mozkan/weddingdress/README.md

# WedfestDress

Datasheets are not checked into this repository. They can be found here:
https://www.dropbox.com/sh/xb0569z05b4rpry/AAB6PzJzVCwgI6VpaBfMWfP8a?dl=0
