mozkan/weddingdress/hw/pcb/controller/bom/Wedfestdress Controller BOM.ods

Qty | Parts | DESCRIPTION | MFG | MFG_PART_NO | DISTRIBUTOR | DIST_PART_NO | COST_X1 | COST_X100 | COST_X500 | PACKAGE | NOSTUFF | Required Qty.
1 | J1 | USB Micro B | FCI | 10118192-0001LF | Digikey | 609-4613-1-ND | 0.46 | 0.3032 | 0.25988 | SMT |  | 5
1 | U23 | Accelerometer, 3G, 550 Hz / 1.6 kHz | Analog Devices | ADXL337BCPZ-RL7 | Digikey | ADXL337BCPZ-RL7CT-ND | 4.58 | 3.3677 | 2.86682 | SMT |  | 5
5 | C2, C3, C12, C13, C15 | Capacitor, 0.1 uF, 50V, 0603, X7R | TDK | C1608X7R1H104K080AA | Digikey | 445-1314-1-ND | 0.1 | 0.022 | 0.0154 | 603 |  | 25
2 | C7, C8 | Capacitor, 4.7 uF, 10V, 0603, X5R | TDK | CGB3B1X5R1A475M055AC | Digikey | 445-7483-1-ND | 0.24 | 0.1 | 0.06626 | 603 |  | 10
2 | C4, C5 | Capacitor, 10 nF, 50V, 0603, X7R | Samsung | CL10B103KB8NNNC | Digikey | 1276-1009-1-ND | 0.1 | 0.0078 | 0.00542 | 603 |  | 10
8 | C6, C9, C10, C11, C16, C17, C18, C19 | Capacitor, 1 uF, 16V, 0603, X5R | Murata | GRM185R61C105KE44D | Digikey | 490-3894-1-ND | 0.11 | 0.0356 | 0.02512 | 603 |  | 40
2 | C1, C14 | Capacitor, 0.1 uF, 25V, 0603, X7R | Murata | GRM188R71E104KA01D | Digikey | 490-1524-1-ND | 0.1 | 0.0088 | 0.00616 | 603 |  | 10
1 | J12 | Connector, 3 pin, 1.25 mm pitch, SMT, R/A | Hirose | DF13-3P-1.25H(20) | Digikey | H2220-ND | 0.46 | 0.3284 | 0.2856 | SMT |  | 5
1 | J3 | Connector, 5 pin, 1.25 mm pitch, SMT, R/A | Hirose | DF13-5P-1.25H(51) | Digikey | H121936CT-ND | 1.24 | 0.9438 | 0.7722 | SMT |  | 5
1 | FB1 | Ferrite Bead, 1k @ 100 MHz, 300 mOhm DCR, 300 mA, 0603 package | Taiyo Yuden | BK1608TS102-T | Digikey | 587-1895-1-ND | 0.1 | 0.0426 | 0.0227 | 603 |  | 5
1 | D3 | LED, Red, 104 mcd @ 20 mA, 0603 | OSRAM | LS Q976-NR-1 | Digikey | 475-2512-1-ND | 0.1 | 0.035 | 0.035 | 603 |  | 5
2 | D1, D2 | LED, Green, Clear, 6 mcd @ 10 mA, 0603 | Lite-On | LTST-C190GKT | Digikey | 160-1183-1-ND | 0.29 | 0.1242 | 0.07038 | 603 |  | 10
1 | U1 | Microcontroller, Cortex M4F + Cortex M0+, 100 MHz, 256 kB flash, 192 kB SRAM | NXP | LPC54114J256BD64QL | Digikey | 568-13034-ND | 7.79 | 5.8259 | 5.07316 | LQFP64 |  | 5
1 | U22 | Digital potentiometer, 100k, 100 taps, I2C | Microchip | MCP4017T-104E/LT | Digikey | MCP4017T-104E/LTCT-ND | 0.53 | 0.4017 | 0.4017 | SC-70-6 |  | 5
1 | U21 | OpAmp, 500 kHz GBWP, rail-to-rail, 50 uA Iq | Microchip | MCP6241UT-E/LT | Digikey | MCP6241UT-E/LTCT-ND | 0.31 | 0.2369 | 0.2369 | SC-70-5 |  | 5
1 | J2 | Connector, 2 position, 3 mm pitch, SMT, RA, 8.5 A per pin | Molex | 436500209 | Digikey | WM1880CT-ND | 2.03 | 1.5782 | 1.5782 | SMT |  | 5
1 | J10 | Connector, 2 position, 1.25 mm pitch, SMT, RA, 1.5 A per pin | Molex | 5041950270 | Digikey | WM10583CT-ND | 0.91 | 0.6938 | 0.56766 | SMT |  | 5
1 | J11 | Connector, 3 position, 1.25 mm pitch, SMT, RA, 1.5 A per pin | Molex | 5041950370 | Digikey | WM10584CT-ND | 1.28 | 0.968 | 0.792 | SMT |  | 5
6 | J4, J5, J6, J7, J8, J9 | Connector, 4 position, 1.25 mm pitch, SMT, RA, 1.5 A per pin | Molex | 5041950370 | Digikey | WM10584CT-ND | 1.28 | 0.968 | 0.792 | SMT |  | 30
30 | TVS1, TVS2, TVS3, TVS4, TVS5, TVS6, TVS7, TVS8, TVS9, TVS10, TVS11, TVS12, TVS13, TVS14, TVS15, TVS16, TVS17, TVS18, TVS19, TVS20, TVS21, TVS22, TVS23, TVS24, TVS25, TVS26, TVS27, TVS28, TVS29, TVS30 | TVS diode, 5 Vs, 5.8 Vbr, 8 Vcl, 0.95 pF, 8 kV, 200 mW | NXP | PESD5V0X1UB,135 | Digikey | 1727-5906-1-ND | 0.45 | 0.288 | 0.22626 | SOD523 |  | 150
2 | R24, R25 | Resistor, 100k, 1%, 0603, 100 ppm/C | Yageo | RC0603FR-07100KL | Digikey | 311-100KHRCT-ND | 0.1 | 0.0052 | 0.00316 | 603 |  | 10
1 | R21 | Resistor, 100k, 1%, 0603, 100 ppm/C | Yageo | RC0603FR-07100KL | Digikey | 311-100KHRCT-ND | 0.1 | 0.0052 | 0.00316 | 603 | NOSTUFF | 5
16 | R1, R6, R7, R8, R9, R10, R11, R12, R13, R14, R15, R16, R17, R18, R19, R26 | Resistor, 10k, 1%, 0603, 100 ppm/C | Yageo | RC0603FR-0710KL | Digikey | 311-10.0KHRCT-ND | 0.01 | 0.0063 | 0.00382 | 603 |  | 80
1 | R2 | Resistor, 15k, 1%, 0603 | Yageo | RC0603FR-0715KL | Digikey | 311-15.0KHRCT-ND | 0.1 | 0.0057 | 0.00348 | 603 |  | 5
1 | R5 | Resistor, 1.5k, 1%, 0603 | Yageo | RC0603FR-071K5L | Digikey | 311-1.50KHRCT-ND | 0.1 | 0.0057 | 0.00348 | 603 | NOSTUFF | 5
4 | R20, R29, R30, R31 | Resistor, 1K, 1%, 0603 | Panasonic | ERJ-3EKF1001V | Digikey | P1.00KHCT-ND | 0.1 | 0.0114 | 0.00624 | 603 |  | 20
2 | R22, R23 | Resistor, 2.2k, 1%, 0603, 100 ppm/C | Panasonic | ERJ-3EKF2201V | Digikey | P2.20KHCT-ND | 0.1 | 0.0084 | 0.00514 | 603 |  | 10
2 | R3, R4 | Resistor, 33R, 0603 | Yageo | RC0603FR-0733RL | Digikey | 311-33.0HRCT-ND | 0.1 | 0.0057 | 0.00348 | 603 |  | 10
12 | U4, U5, U6, U7, U8, U9, U10, U11, U12, U13, U14, U15 | Level shifter, 1 channel, 5.5 V | Texas Instruments | SN74LVC1T45DCKR | Digikey | 296-16844-1-ND | 0.58 | 0.3699 | 0.29056 | SC-70-6 |  | 60
1 | U2 | LDO, 3.3V, 200 mA, 1%, 0.22V dropout | Toshiba | TCR2LF33,LM(CT | Digikey | TCR2LF33LM(CTCT-ND | 0.45 | 0.1911 | 0.10816 | SMV |  | 5
6 | U3, U16, U17, U18, U19, U20 | Load switch, high side, 3A | TI | TPS27081ADDCR | Digikey | 296-34970-1-ND | 0.44 | 0.2781 | 0.2043 | SOT-23-6 |  | 30
12 | TP1, TP2, TP3, TP4, TP5, TP6, TP7, TP8, TP9, TP10, TP11, TP12 | Test point, SMT, circular, 1.6 mm diameter |  |  |  |  |  |  |  |  |  | 60
1 | SW4 | Switch, SPDT, Sub-Miniature, RA, SMT | Copal | CL-SB-22B-12T | Digikey | 563-1345-1-ND | 1.35 | 1.0771 | 1.0502 | SMT |  | 5
3 | SW1, SW2, SW3 | Tact Switch, SPST, Vert | C and K | KMR221NG LFS | Digikey | CKN10244CT-ND | 0.51 | 0.4017 | 0.34694 | SMT |  | 15
Build Qty
5
