mozkan/weddingdress/hw/pcb/microphone/bom/Wedfestdress Microphone BOM.ods

Qty | Parts | DESCRIPTION | MFG | MFG_PART_NO | DISTRIBUTOR | DIST_PART_NO | COST_X1 | COST_X100 | COST_X500 | PACKAGE | NOSTUFF | Required Qty.
1 | C3 | Capacitor, 0.1 uF, 50V, 0603, X7R | TDK | C1608X7R1H104K080AA | Digikey | 445-1314-1-ND | 0.1 | 0.022 | 0.0154 | 603 |  | 5
2 | C1, C2 | Capacitor, 4.7 uF, 10V, 0603, X5R | TDK | CGB3B1X5R1A475M055AC | Digikey | 445-7483-1-ND | 0.24 | 0.1 | 0.06626 | 603 |  | 10
1 | C4 | Capacitor, 2.2 uF, 10V, 0603, X5R | Samsung | CL10A225KP8NNNC | Digikey | 1276-1085-1-ND | 0.12 | 0.0408 | 0.02878 | 603 |  | 5
1 | C5 | Capacitor, 15 pF, 50V, 0603, C0G/NP0 | Samsung | CL10C150JB8NNNC | Digikey | 1276-1296-1-ND | 0.1 | 0.0126 | 0.00898 | 603 |  | 5
1 | U1 | OpAmp, 500 kHz GBWP, rail-to-rail, 50 uA Iq | Microchip | MCP6241UT-E/LT | Digikey | MCP6241UT-E/LTCT-ND | 0.31 | 0.2369 | 0.2369 | SC-70-5 |  | 5
1 | MIC1 | Microphone, electret condenser, omnidirectional, -38 dB sensitivity, 20 Hz - 15 kHz, TH | PUI Audio | POM-5238P-R | Digikey | 668-1324-ND | 2.52 | 1.332 | 1.332 | TH |  | 5
1 | R4 | Resistor, 0R, 0603 | Yageo | RC0603JR-070RL | Digikey | 311-0.0GRCT-ND | 0.1 | 0.0045 | 0.00278 | 603 |  | 5
1 | R7 | Resistor, 100k, 1%, 0603, 100 ppm/C | Yageo | RC0603FR-07100KL | Digikey | 311-100KHRCT-ND | 0.1 | 0.0052 | 0.00316 | 603 |  | 5
2 | R2, R3 | Resistor, 10k, 1%, 0603, 100 ppm/C | Yageo | RC0603FR-0710KL | Digikey | 311-10.0KHRCT-ND | 0.01 | 0.0063 | 0.00382 | 603 |  | 10
1 | R1 | Resistor, 2.2k, 1%, 0603, 100 ppm/C | Panasonic | ERJ-3EKF2201V | Digikey | P2.20KHCT-ND | 0.1 | 0.0084 | 0.00514 | 603 |  | 5
1 | R6 | Resistor, 49R9, 1%, 0603, 100 ppm/C | Yageo | RC0603FR-0749R9L | Digikey | 311-49.9HRCT-ND | 0.1 | 0.0063 | 0.00382 | 603 |  | 5
1 | R5 | Resistor, 75k, 1%, 0603, 100 ppm/C | Yageo | RC0603FR-0775KL | Digikey | 311-75.0KHRCT-ND | 0.1 | 0.006 | 0.006 | 603 |  | 5
3 | TP1, TP2, TP3 | Test point, SMT, circular, 1.6 mm diameter
Build Qty
5
