mozkan/weddingdress/hw/pcb/pixel/bom/Wedfestdress Pixel BOM.ods

Qty | Parts | DESCRIPTION | MFG | MFG_PART_NO | DISTRIBUTOR | DIST_PART_NO | COST_X1 | COST_X100 | COST_X500 | PACKAGE | NOSTUFF | Required Qty. | Notes
1 | U1 | RGB LED, daisy-chainable, SPI-compatible, 5050 case size | iPixel | APA102C | Amazon | B01MG4TG58 | 0.23 | 0.23 | 0.23 | 5050 |  | 175
4 | TVS1, TVS2, TVS3, TVS4 | TVS diode, 5 Vs, 5.8 Vbr, 8 Vcl, 0.95 pF, 8 kV, 200 mW | NXP | PESD5V0X1UB,135 | Digikey | 1727-5906-1-ND | 0.45 | 0.288 | 0.22626 | SOD523 |  | 700 | Alternate (lower cost): MCC ESD5V0D5-TP
8 | TP1, TP2, TP3, TP4, TP5, TP6, TP7, TP8 | Test point, SMT, circular, 1.6 mm diameter
Build Qty
175
