mozkan/weddingdress/doc/LED Wiring Calculations.ods

LED | APA102C
LED max current consumption | 0.04 | A
LED avg. current consumption factor | 0.4
LED avg. current consumption | 0.016 | A
Wire gauge ampacity | 26 | Ohms / 1000 ft | (24 AWG)
Wire gauge ampacity | 0.026 | Ohms / ft
Strip segment | 4 | ft | (one length from waist to floor)
Segments per strip | 3
Strip length | 12 | ft
Strip resistance | 0.312
LED supply voltage | 3.7 | V
LED spacing | 3 | LEDs / ft
LEDs per strip | 36
Max strip current | 1.44 | A
Max strip voltage drop | 0.44928 | V
Min LED supply voltage at strip end | 3.25072 | V
Battery pack energy | 1.4 | Ah
Battery packs | 4
Total dress energy | 5.6 | Ah
Number of strips | 4
Total LEDs | 144
Average dress current | 2.304 | A
Max dress current | 5.76 | A
Dress runtime | 2.43055555555555 | Hours
