mozkan/weddingdress/hw/pcb/controller/controller.brd

## EAGLE design hw/pcb/controller/controller.brd (2017-06-20)

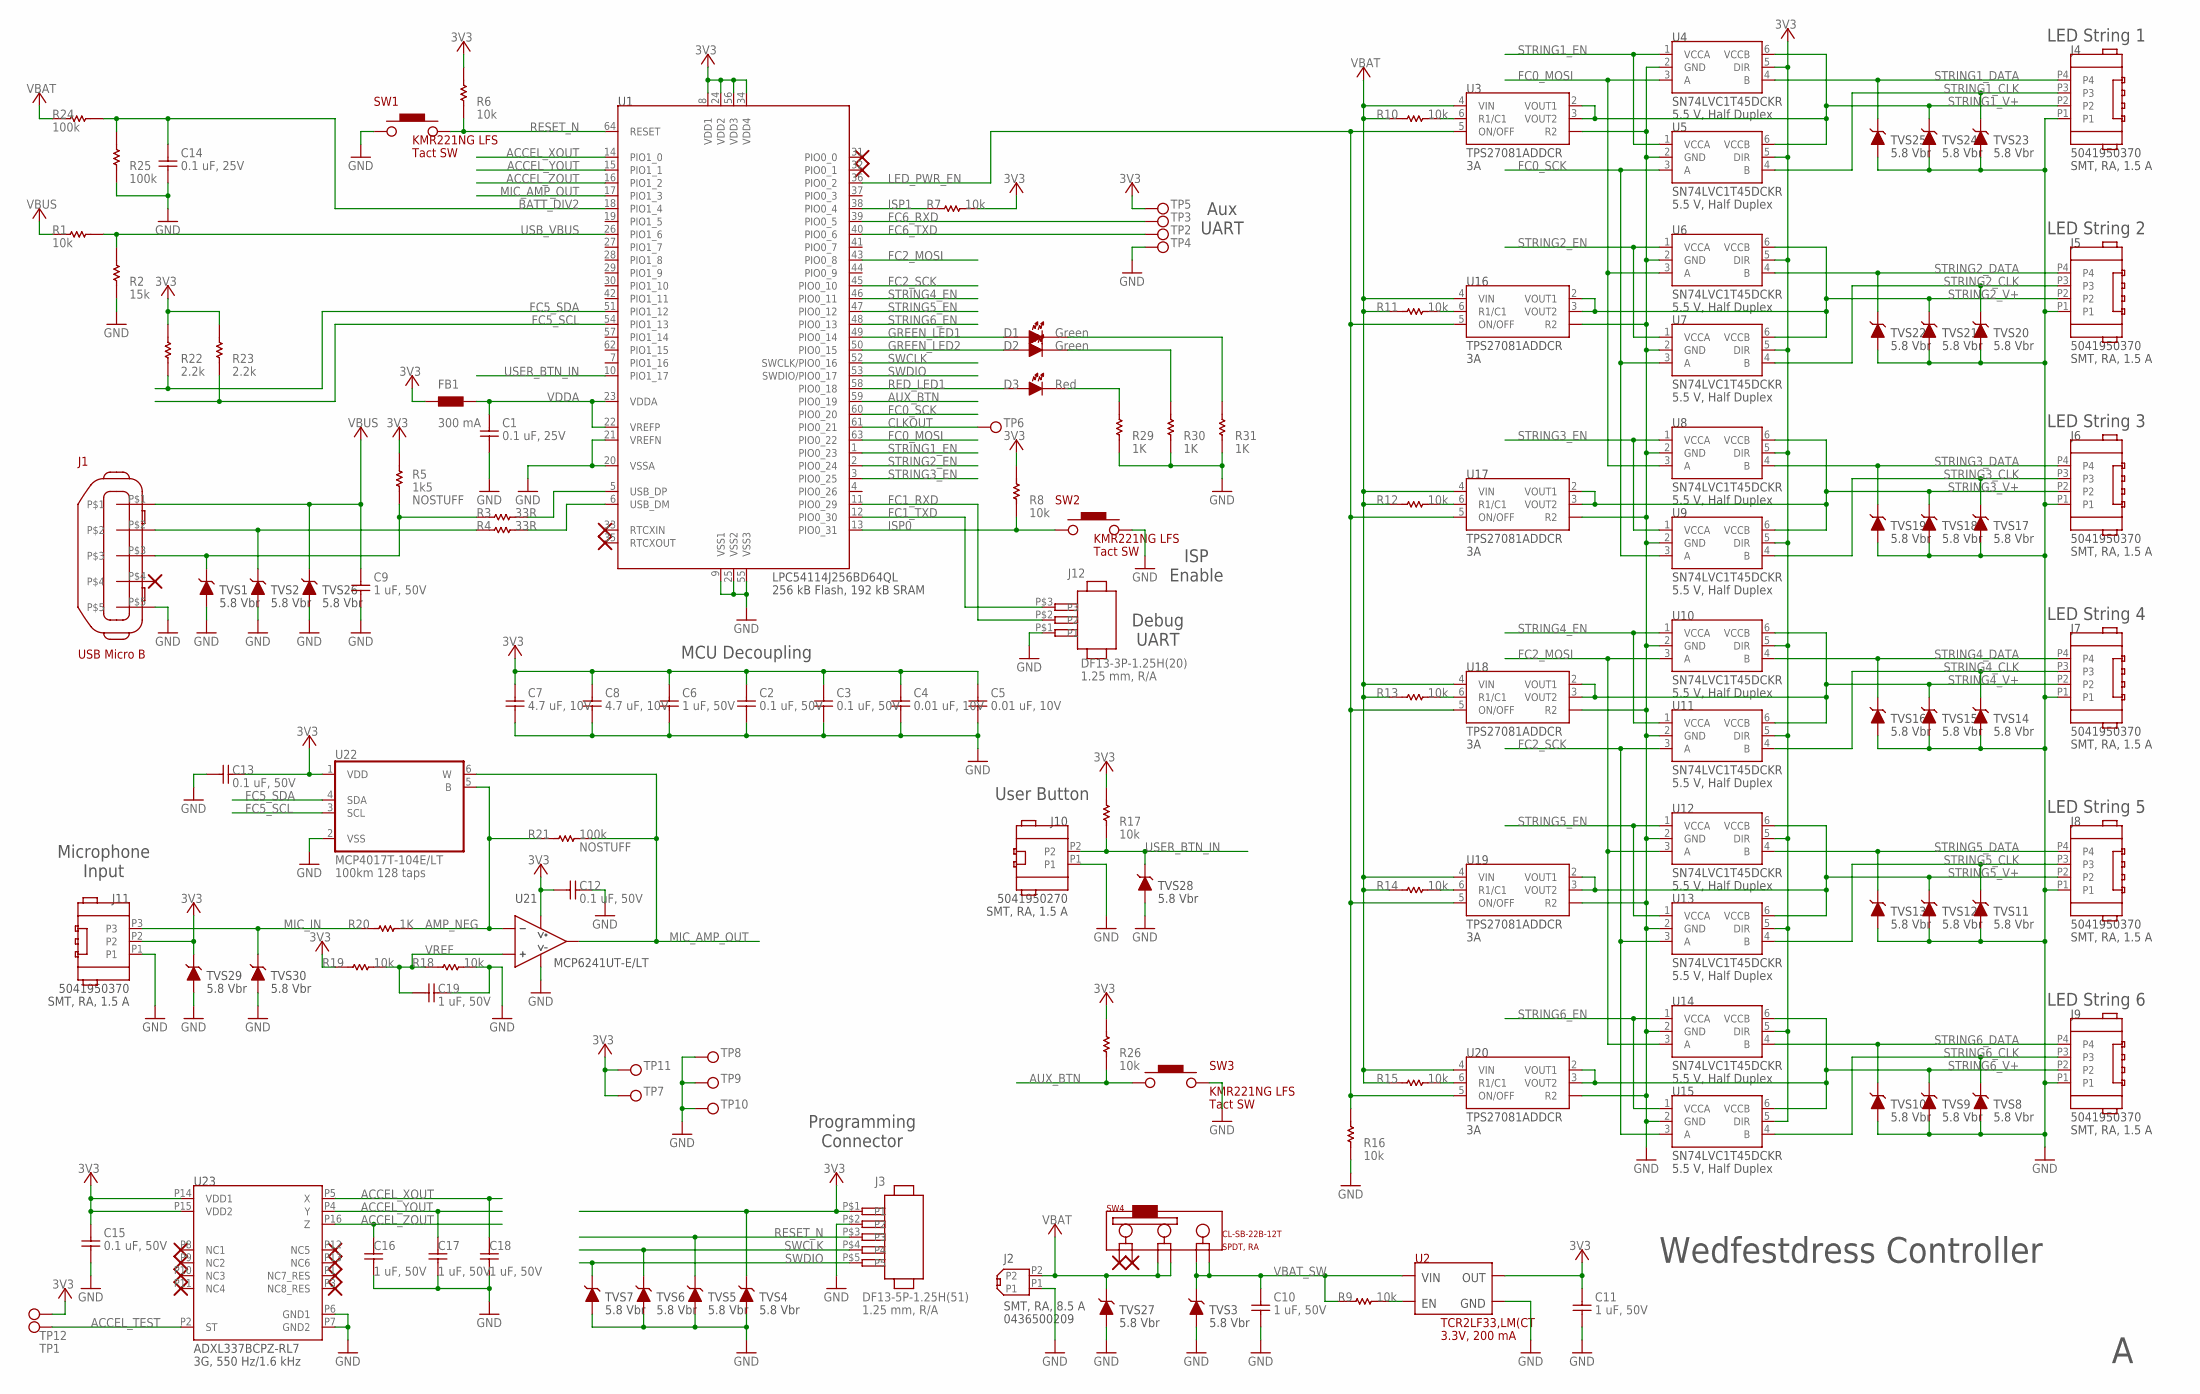
[picture p1: schematic controller.sch]

Parts:
C1, C14: CAP_GRM188R71E104KA01D; CAP_0603
C2, C3, C12, C13, C15: CAP_C1608X7R1H104K080AA; CAP_0603
C4, C5: CAP_CL10B103KB8NNNC; CAP_0603
C6, C9, C10, C11, C16, C17, C18, C19: CAP_GRM185R61C105KE44D; CAP_0603
C7, C8: CAP_CGB3B1X5R1A475M055AC; CAP_0603
D1, D2: LED_LTST-C190GKT; LED_0603
D3: LED_LS_Q976-NR-1; LED_0603_OSRAM
FB1: FB_BK1608TS102-T; FB_0603
J1: 10118192-0001LF
J2: MOLEX_0436500209; MOLEX_MICROFIT_2POS_SMT_RA_W_BOSSES
J3: DF13-5P-1.25H
J4, J5, J6, J7, J8, J9: MOLEX_5041950470; MOLEX_MICROLOCK_RA_4_POS
J10: MOLEX_5041950270; MOLEX_MICROLOCK_RA_2_POS
J11: MOLEX_5041950370; MOLEX_MICROLOCK_RA_3_POS
J12: DF13-3P-1.25H
R1, R6, R7, R8, R9, R10, R11, R12, R13, R14, R15, R16, R17, R18, R19, R26: RES_10K_RC0603FR-0710KL; RES_0603
R2: RES_15K_RC0603FR-0715KL; RES_0603
R3, R4: RES_33R_RC0603FR-0733RL; RES_0603
R5: RES_1K5_RC0603FR-071K5L; RES_0603
R20, R29, R30, R31: RES_1K_ERJ-3EKF1001V; RES_0603
R21, R24, R25: RES_100K_RC0603FR-07100KL; RES_0603
R22, R23: RES_2K2_ERJ-3EKF2201V; RES_0603
SW1, SW2, SW3: KMR221NG; KMR2
SW4: CL-SB-22B-12T
TP1, TP2, TP3, TP4, TP5, TP6, TP7, TP8, TP9, TP10, TP11, TP12: TP_1P6_MM_ROUND
TVS1, TVS2, TVS3, TVS4, TVS5, TVS6, TVS7, TVS8, TVS9, TVS10, TVS11, TVS12, TVS13, TVS14, TVS15, TVS16, TVS17, TVS18, TVS19, TVS20, TVS21, TVS22, TVS23, TVS24, TVS25, TVS26, TVS27, TVS28, TVS29, TVS30: PESD5V0X1UB,135; SOD523
U1: LPC54114J256BD64; LQFP64_0P5MM_10X10MM
U2: TCR2LF33,LM(CT; TOSHIBA_SMV
U3, U16, U17, U18, U19, U20: TPS27081; SOT-23-6_GENERIC
U4, U5, U6, U7, U8, U9, U10, U11, U12, U13, U14, U15: SN74LVC1T45DCKR; SC-70-6_GENERIC
U21: MCP6241UT-E/LT; SC-70-5_GENERIC
U22: MCP4017T; SOT65P210X110-6N
U23: ADXL337

Connections:
3V3: C2.P$1, C3.P$1, C4.P$1, C5.P$1, C6.P$1, C7.P$1, C8.P$1, C11.P$1, C12.P$1, C13.P$2, C15.P$1, FB1.P$1, J3.P$1 (P1), J11.P2, R5.P$2, R6.P$2, R7.P$1, R8.P$2, R17.P$2, R19.P$2, R22.P$2, R23.P$2, R26.P$2, TP5.P$1, TP7.P$1, TP11.P$1, TP12.P$1, TVS4.K, TVS29.K, U1.8 (VDD1), U1.24 (VDD2), U1.34 (VDD4), U1.56 (VDD3), U2.P5 (OUT), U4.5 (DIR), U5.5 (DIR), U6.5 (DIR), U7.5 (DIR), U8.5 (DIR), U9.5 (DIR), U10.5 (DIR), U11.5 (DIR), U12.5 (DIR), U13.5 (DIR), U14.5 (DIR), U15.5 (DIR), U21.5 (V+), U22.1 (VDD), U23.P14 (VDD1), U23.P15 (VDD2)
+6V: C9.P$1, J1.P$1, R1.P$2, TVS26.K
ACCEL_TEST: TP1.P$1, U23.P2 (ST)
ACCEL_XOUT: C18.P$1, U1.14 (PIO1_0), U23.P5 (X)
ACCEL_YOUT: C17.P$1, U1.15 (PIO1_1), U23.P4 (Y)
ACCEL_ZOUT: C16.P$1, U1.16 (PIO1_2), U23.P16 (Z)
AMP_NEG: R20.P$2, R21.P$1, U21.3 (IN-), U22.5 (B)
AUX_BTN: R26.P$1, SW3.P1, U1.59 (PIO0_19)
BATT_DIV2: C14.P$1, R24.P$1, R25.P$2, U1.18 (PIO1_4)
CLKOUT: TP6.P$1, U1.61 (PIO0_21)
FC0_MOSI: U1.63 (PIO0_22), U4.3 (A), U6.3 (A), U8.3 (A)
FC0_SCK: U1.60 (PIO0_20), U5.3 (A), U7.3 (A), U9.3 (A)
FC1_RXD: J12.P$2 (P2), U1.11 (PIO0_29)
FC1_TXD: J12.P$3 (P3), U1.12 (PIO0_30)
FC2_MOSI: U1.43 (PIO0_8), U10.3 (A), U12.3 (A), U14.3 (A)
FC2_SCK: U1.45 (PIO0_10), U11.3 (A), U13.3 (A), U15.3 (A)
FC5_SCL: R23.P$1, U1.54 (PIO1_13), U22.3 (SCL)
FC5_SDA: R22.P$1, U1.51 (PIO1_12), U22.4 (SDA)
FC6_RXD: TP3.P$1, U1.39 (PIO0_5)
FC6_TXD: TP2.P$1, U1.40 (PIO0_6)
GND: C1.P$2, C2.P$2, C3.P$2, C4.P$2, C5.P$2, C6.P$2, C7.P$2, C8.P$2, C9.P$2, C10.P$2, C11.P$2, C12.P$2, C13.P$1, C14.P$2, C15.P$2, C16.P$2, C17.P$2, C18.P$2, C19.P$2, J1.P$5, J2.P1, J3.P$2 (P2), J4.P1, J5.P1, J6.P1, J7.P1, J8.P1, J9.P1, J10.P1, J11.P1, J12.P$1 (P1), R2.P$1, R16.P$1, R18.P$1, R25.P$1, R29.P$1, R30.P$1, R31.P$1, SW1.P1, SW2.P3 (P2), SW3.P3 (P2), TP4.P$1, TP8.P$1, TP9.P$1, TP10.P$1, TVS1.A, TVS2.A, TVS3.A, TVS4.A, TVS5.A, TVS6.A, TVS7.A, TVS8.A, TVS9.A, TVS10.A, TVS11.A, TVS12.A, TVS13.A, TVS14.A, TVS15.A, TVS16.A, TVS17.A, TVS18.A, TVS19.A, TVS20.A, TVS21.A, TVS22.A, TVS23.A, TVS24.A, TVS25.A, TVS26.A, TVS27.A, TVS28.A, TVS29.A, TVS30.A, U1.9 (VSS1), U1.20 (VSSA), U1.21 (VREFN), U1.25 (VSS2), U1.55 (VSS3), U2.P2 (GND), U3.1 (R2), U4.2 (GND), U5.2 (GND), U6.2 (GND), U7.2 (GND), U8.2 (GND), U9.2 (GND), U10.2 (GND), U11.2 (GND), U12.2 (GND), U13.2 (GND), U14.2 (GND), U15.2 (GND), U16.1 (R2), U17.1 (R2), U18.1 (R2), U19.1 (R2), U20.1 (R2), U21.2 (V-), U22.2 (VSS), U23.P6 (GND1), U23.P7 (GND2)
GREEN_LED1: D1.A, U1.49 (PIO0_14)
GREEN_LED2: D2.A, U1.50 (PIO0_15)
ISP0: R8.P$1, SW2.P1, U1.13 (PIO0_31)
ISP1: R7.P$2, U1.38 (PIO0_4)
LED_PWR_EN: R16.P$2, U1.36 (PIO0_2), U3.5 (ON/OFF), U16.5 (ON/OFF), U17.5 (ON/OFF), U18.5 (ON/OFF), U19.5 (ON/OFF), U20.5 (ON/OFF)
MIC_AMP_OUT: R21.P$2, U1.17 (PIO1_3), U21.4 (OUT), U22.6 (W)
MIC_IN: J11.P3, R20.P$1, TVS30.K
unnamed: R10.P$2, U3.6 (R1/C1)
unnamed: R3.P$2, U1.5 (USB_DP)
unnamed: R4.P$2, U1.6 (USB_DM)
unnamed: J1.P$2, R4.P$1, TVS2.K
unnamed: J1.P$3, R3.P$1, R5.P$1, TVS1.K
unnamed: R9.P$1, U2.P3 (EN)
unnamed: D3.K, R29.P$2
unnamed: D2.K, R30.P$2
unnamed: D1.K, R31.P$2
unnamed: R15.P$2, U20.6 (R1/C1)
unnamed: R11.P$2, U16.6 (R1/C1)
unnamed: R12.P$2, U17.6 (R1/C1)
unnamed: R13.P$2, U18.6 (R1/C1)
unnamed: R14.P$2, U19.6 (R1/C1)
RED_LED1: D3.A, U1.58 (PIO0_18)
RESET_N: J3.P$3 (P3), R6.P$1, SW1.P3 (P2), TVS5.K, U1.64 (RESET)
STRING1_CLK: J4.P3, TVS23.K, U5.4 (B)
STRING1_DATA: J4.P4, TVS25.K, U4.4 (B)
STRING1_EN: U1.1 (PIO0_23), U4.1 (VCCA), U5.1 (VCCA)
STRING1_V+: J4.P2, TVS24.K, U3.2 (VOUT1), U3.3 (VOUT2), U4.6 (VCCB), U5.6 (VCCB)
STRING2_CLK: J5.P3, TVS20.K, U7.4 (B)
STRING2_DATA: J5.P4, TVS22.K, U6.4 (B)
STRING2_EN: U1.2 (PIO0_24), U6.1 (VCCA), U7.1 (VCCA)
STRING2_V+: J5.P2, TVS21.K, U6.6 (VCCB), U7.6 (VCCB), U16.2 (VOUT1), U16.3 (VOUT2)
STRING3_CLK: J6.P3, TVS17.K, U9.4 (B)
STRING3_DATA: J6.P4, TVS19.K, U8.4 (B)
STRING3_EN: U1.3 (PIO0_25), U8.1 (VCCA), U9.1 (VCCA)
STRING3_V+: J6.P2, TVS18.K, U8.6 (VCCB), U9.6 (VCCB), U17.2 (VOUT1), U17.3 (VOUT2)
STRING4_CLK: J7.P3, TVS14.K, U11.4 (B)
STRING4_DATA: J7.P4, TVS16.K, U10.4 (B)
STRING4_EN: U1.46 (PIO0_11), U10.1 (VCCA), U11.1 (VCCA)
STRING4_V+: J7.P2, TVS15.K, U10.6 (VCCB), U11.6 (VCCB), U18.2 (VOUT1), U18.3 (VOUT2)
STRING5_CLK: J8.P3, TVS11.K, U13.4 (B)
STRING5_DATA: J8.P4, TVS13.K, U12.4 (B)
STRING5_EN: U1.47 (PIO0_12), U12.1 (VCCA), U13.1 (VCCA)
STRING5_V+: J8.P2, TVS12.K, U12.6 (VCCB), U13.6 (VCCB), U19.2 (VOUT1), U19.3 (VOUT2)
STRING6_CLK: J9.P3, TVS8.K, U15.4 (B)
STRING6_DATA: J9.P4, TVS10.K, U14.4 (B)
STRING6_EN: U1.48 (PIO0_13), U14.1 (VCCA), U15.1 (VCCA)
STRING6_V+: J9.P2, TVS9.K, U14.6 (VCCB), U15.6 (VCCB), U20.2 (VOUT1), U20.3 (VOUT2)
SWCLK: J3.P$4 (P4), TVS6.K, U1.52 (SWCLK/PIO0_16)
SWDIO: J3.P$5 (P5), TVS7.K, U1.53 (SWDIO/PIO0_17)
USB_VBUS: R1.P$1, R2.P$2, U1.26 (PIO1_6)
USER_BTN_IN: J10.P2, R17.P$1, TVS28.K, U1.10 (PIO1_17)
VBAT: J2.P2, R10.P$1, R11.P$1, R12.P$1, R13.P$1, R14.P$1, R15.P$1, R24.P$2, SW4.3, SW4.4, TVS27.K, U3.4 (VIN), U16.4 (VIN), U17.4 (VIN), U18.4 (VIN), U19.4 (VIN), U20.4 (VIN)
VBAT_SW: C10.P$1, R9.P$2, SW4.5, SW4.6, TVS3.K, U2.P1 (VIN)
VDDA: C1.P$1, FB1.P$2, U1.22 (VREFP), U1.23 (VDDA)
VREF: C19.P$1, R18.P$2, R19.P$1, U21.1 (IN+)

Notes on the sheet:
Wedfestdress Controller
Programming Connector
MCU Decoupling
LED String 1
LED String 2
LED String 3
LED String 4
LED String 5
LED String 6
Debug UART
ISP Enable
User Button
Microphone Input
Aux UART

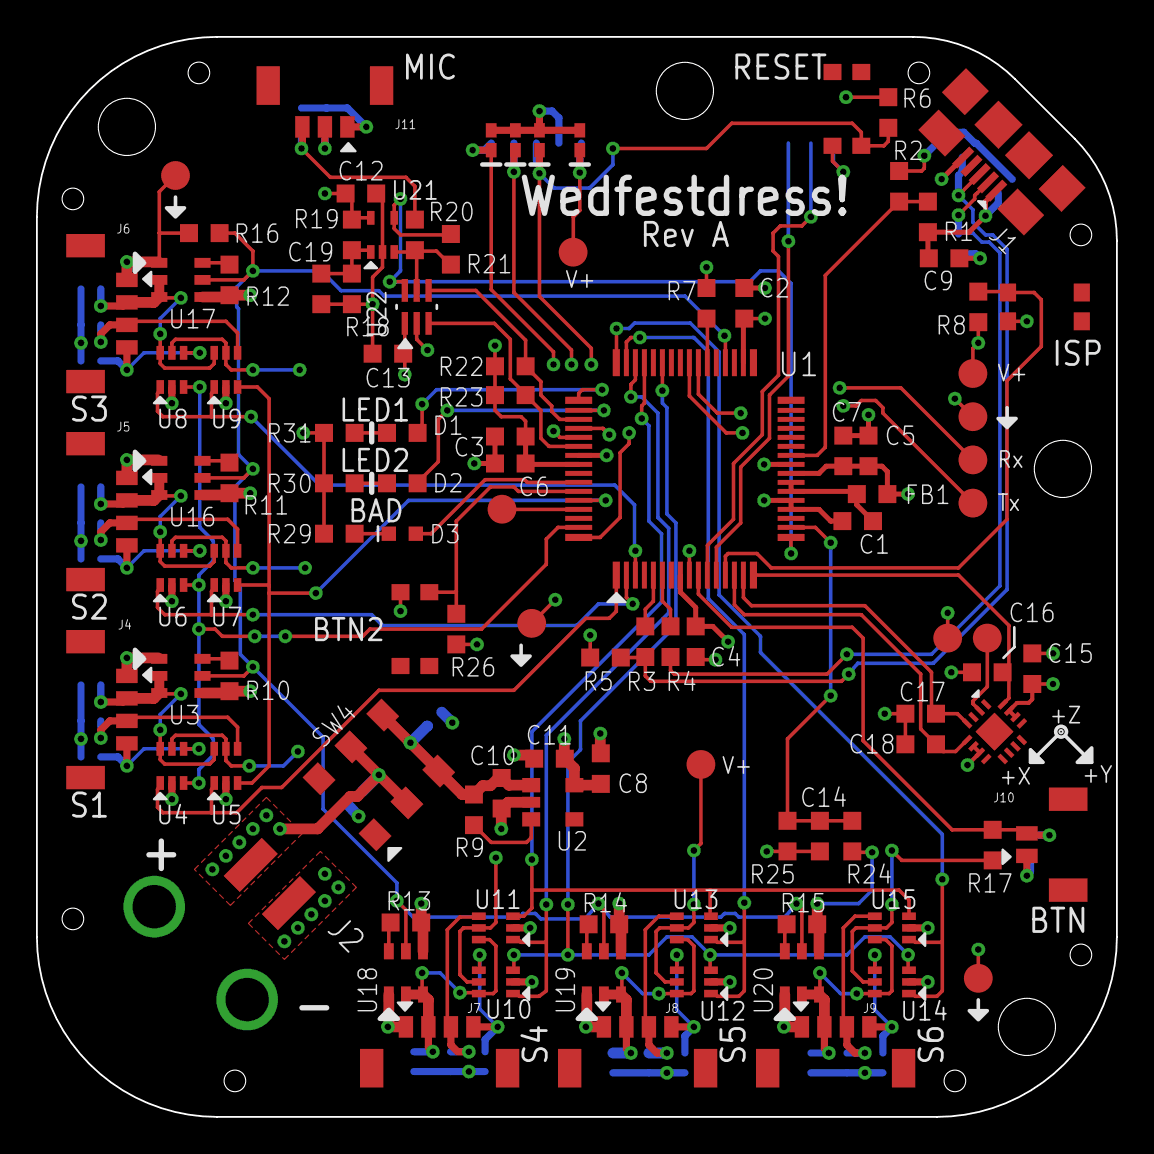
[picture p2: board controller.brd from above]

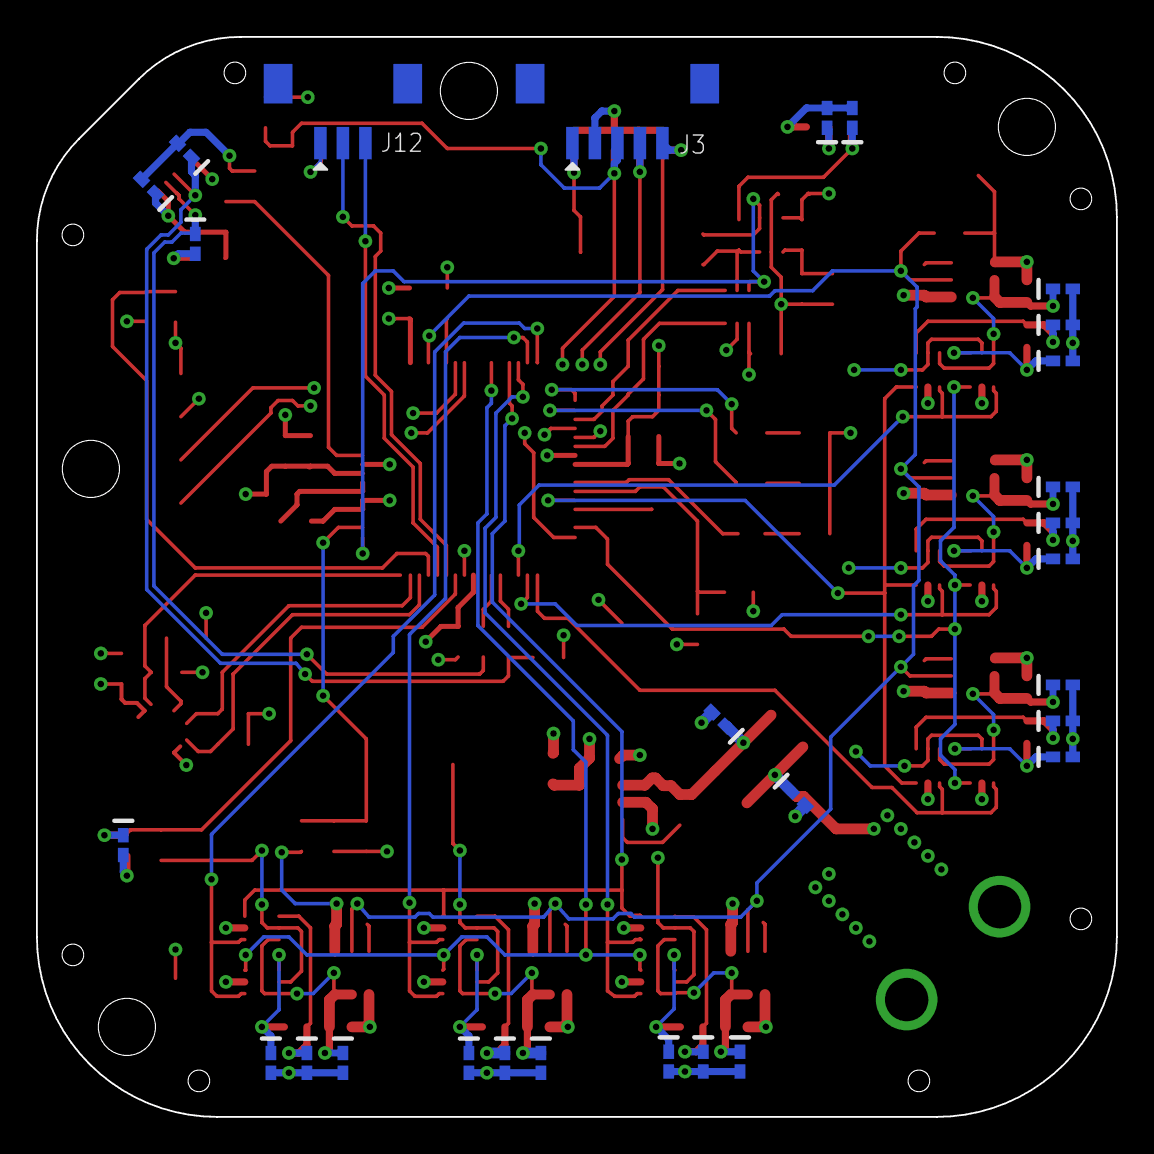
[picture p3: board controller.brd from below]

Board: 4 copper layers, 60.0 x 60.0 mm, 133 parts (28 on the bottom side), 76 nets.
