mozkan/weddingdress/hw/pcb/pixel/pixel.brd

## EAGLE design hw/pcb/pixel/pixel.brd (2017-06-20)

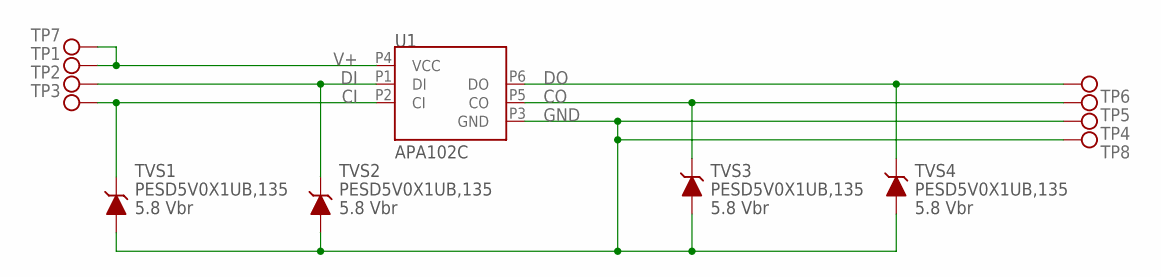
[picture p4: schematic pixel.sch]

Parts:
TP1, TP2, TP3, TP4, TP5, TP6, TP7, TP8: TP_1P6_MM_ROUND
TVS1, TVS2, TVS3, TVS4: PESD5V0X1UB,135; SOD523
U1: APA102C

Connections:
CI: TP3.P$1, TVS1.K, U1.P2 (CI)
CO: TP5.P$1, TVS3.K, U1.P5 (CO)
DI: TP2.P$1, TVS2.K, U1.P1 (DI)
DO: TP6.P$1, TVS4.K, U1.P6 (DO)
GND: TP4.P$1, TP8.P$1, TVS1.A, TVS2.A, TVS3.A, TVS4.A, U1.P3 (GND)
V+: TP1.P$1, TP7.P$1, U1.P4 (VCC)

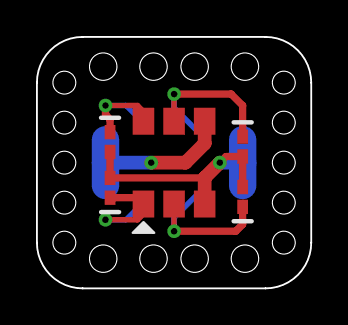
[picture p5: board pixel.brd from above]

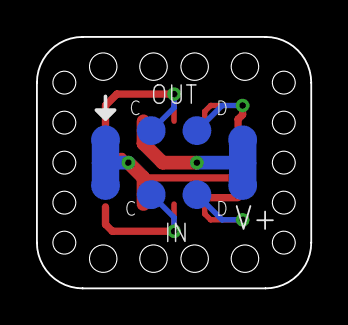
[picture p6: board pixel.brd from below]

Board: 2 copper layers, 15.2 x 14.0 mm, 13 parts (8 on the bottom side), 6 nets.
