mozkan/weddingdress/hw/pcb/microphone/microphone.brd

## EAGLE design hw/pcb/microphone/microphone.brd (2017-06-20)

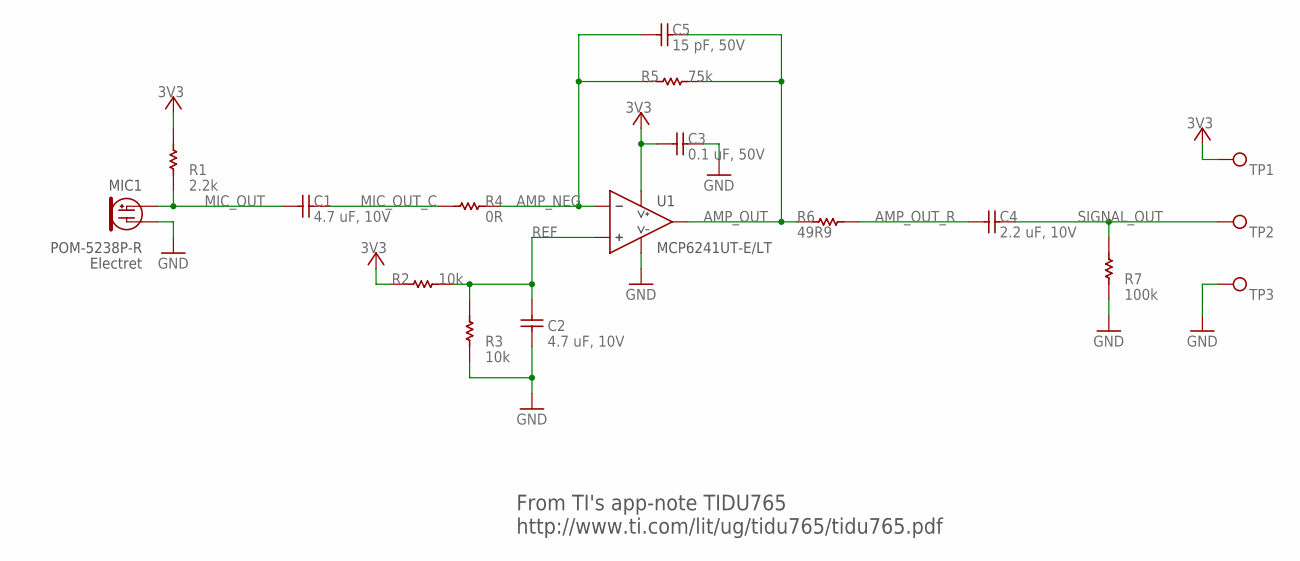
[picture p7: schematic microphone.sch]

Parts:
C1, C2: CAP_CGB3B1X5R1A475M055AC; CAP_0603
C3: CAP_C1608X7R1H104K080AA; CAP_0603
C4: CAP_CL10A225KP8NNNC; CAP_0603
C5: CAP_CL10C150JB8NNNC; CAP_0603
MIC1: POM-5238P-R
R1: RES_2K2_ERJ-3EKF2201V; RES_0603
R2, R3: RES_10K_RC0603FR-0710KL; RES_0603
R4: RES_0R_RC0603JR-070RL; RES_0603
R5: RES_75K_RC0603FR-0775KL; RES_0603
R6: RES_49R9_RC0603FR-0749R9L; RES_0603
R7: RES_100K_RC0603FR-07100KL; RES_0603
TP1, TP2, TP3: TP_1P6_MM_ROUND
U1: MCP6241UT-E/LT; SC-70-5_GENERIC

Connections:
3V3: C3.P$1, R1.P$2, R2.P$2, TP1.P$1, U1.5 (V+)
AMP_NEG: C5.P$1, R4.P$2, R5.P$1, U1.3 (IN-)
AMP_OUT: C5.P$2, R5.P$2, R6.P$1, U1.4 (OUT)
AMP_OUT_R: C4.P$1, R6.P$2
GND: C2.P$1, C3.P$2, MIC1.NEG, R3.P$1, R7.P$1, TP3.P$1, U1.2 (V-)
MIC_OUT: C1.P$1, MIC1.POS, R1.P$1
MIC_OUT_C: C1.P$2, R4.P$1
REF: C2.P$2, R2.P$1, R3.P$2, U1.1 (IN+)
SIGNAL_OUT: C4.P$2, R7.P$2, TP2.P$1

Notes on the sheet:
From TI's app-note TIDU765 http://www.ti.com/lit/ug/tidu765/tidu765.pdf

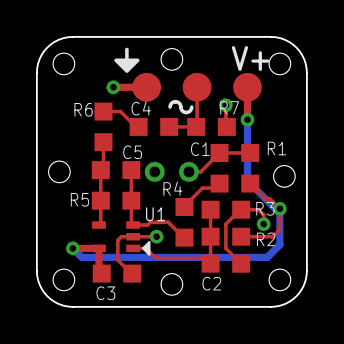
[picture p8: board microphone.brd from above]

Board: 2 copper layers, 15.0 x 15.0 mm, 17 parts (1 on the bottom side), 9 nets.
