mozkan/weddingdress/sw/code/hal/src/Timing.cpp

/**
 * @file Timing.cpp
 *
 * @details Contains the implementation of the Timing class.
 *
 * @author Murat Ozkan
 *
 * Wedfestdress Firmware 2017
 */

//
// Includes
//

#include "MCUConfig.h"

#include "Timing.h"


namespace hal {

//
// Timing Class Definition
//

Timing::Timing(mcu::Timer& timer) : timer_(timer) {
  // Set the prescaler to count 1 millisecond per tick.
  timer_.SetPrescaler(mcu::kCPUClockHz / 1000);

  // Start the timer.
  timer_.Start();
}

Timing::~Timing() { }

uint32_t Timing::Millis(void) {
  return timer_.GetCount();
}

} // namespace hal
