mozkan/weddingdress/(commit log)

2017-02-05 Initial set of calculations for wiring and power
    Sketched out some rough numbers for power consumption, battery life,
    wire gauge, LED spacing, etc. Good first pass for now.
    [LED Wiring Calculations.ods]
2017-02-05 Add blank set of Eagle design files
    Modified with LGPL license in XML. Files are blank with default
    schematic and layout settings.
    [controller.brd, controller.sch, microphone.brd, microphone.sch, pixel.brd, pixel.sch]
2017-02-09 First pass at pixel PCB
    - Add some library footprints.
    - First pass on schematic and layout of pixel PCB.
    [pixel.brd, pixel.sch]
2017-02-10 Tweak hole placement and size, tweak design rules
    - Added holes for threading power wires twice instead of once.
    - Came up with a way to thread the signal wires into the power wired
    so that all are strain relieved well. Two holes on the threading
    holes (small) will be used to thread 28 AWG signal wires through.
    Signal wires will thread through the loop created by the power
    wires.
    - Made holes smaller to match candidate wires with OD of 0.4" and
    0.5".
    - Moved solder pads on bottom side inward to free up space for more
    strain relief holes.
    [pixel.brd]
2017-06-12 Add CAM files for first rev of pixel pcb
    [pixel.GBL, pixel.GBO, pixel.GBP, pixel.GBS, pixel.GTL, pixel.GTO, pixel.GTP, pixel.GTS]
2017-06-12 Update gitignore
    Ignore fab files. Use releases to track these packages.
2017-06-12 Draft of schematic is complete
    Still needs review.
    [controller.brd, controller.sch, pixel.brd]
2017-06-18 Routing and silscreen cleanup complete
    [controller.brd, controller.sch]
2017-06-19 Add microphone board
    Completed schematic and layout of microphone board. Is a similar
    design to the one from TI's tidu765 app-note. Has provisions for a
    more basic non-inverting amplifier design as well. Currently uses a
    transimpedence amplifier.
    [controller.brd, controller.sch, microphone.brd, microphone.sch]
2017-06-20 Add scripts
    - Added CAM generation script for 4 layer board based on Sparkfun's
    script.
    - Added helper script to copy CAM files generated by Eagle into the
    CAM directory.
    - Tweaks to microphone schematic (cosmetic).
    [microphone.sch]
2017-06-20 Final tweaks and CAM output for all three boards
    [controller.GBL, controller.GBO, controller.GBP, controller.GBS, controller.GM1, controller.GTL, controller.GTO, controller.GTP]
2017-06-21 Prepare BOMs for purchasing
    Add BOM directories containing purchasing BOMs for the build.
    Sourced an alternate to the TVS to save some cost in case I need to
    buy 700 for the LEDs.
    [Wedfestdress Controller BOM.ods, Wedfestdress Microphone BOM.ods, Wedfestdress Pixel BOM.ods]
2017-06-25 Add purchasing BOMs for this build
    For Rev A of controller and microphone. Rev B of pixel board.
    [Wedfestdress Controller BOM.ods, Wedfestdress Microphone BOM.ods, Wedfestdress Pixel BOM.ods]
2017-07-05 Add initial source files for software
    Working through porting peripheral and board management management
    code from one of my other projects. Working through the MCU layer at
    the moment - lots of #if 0's still.
    Working in an MCUXpresso project for the time being to speed up setup
    time. Will eventually moved to a managed build, load, debug centered
    around bazel / GDB. Set up LPCOpen as its own static library with its
    own project, linked into the main project. Works alright for fast
    incremental builds of the main project but I still get warnings from
    LPCOpen when I compile the main project.
    LPCOpen seems to be working well for this chip.
    So far, the following features work:
    -Standard C libra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
2017-07-21 Got SPI working on both ports
    Set up pin muxing, peripheral power, and peripheral configuration via
    wrapper class, SPIMaster. Level shifters also work.
    The method used to write to SPI is the simplest: polled + FIFO. Based
    on the activity observed on the scope there is quite a bit of
    overhead using the polled method - around 50%. Eventually, to improve
    processing bandwidth, DMA should be implemented.
    Rework Required:
    -Add 1k pullups to string enable lines on strings 1, 2, and 3.
    [MCU.cpp, MCU.h, MCUConfig.h, PinMux.cpp, SPIMaster.cpp, SPIMaster.h, main.cpp]
2017-07-23 Display driver is written and tested in debugger
    Display driver is written and tested using oscilloscope. Proper write
    sequence and bit ordering looks right. Got a set of APA102 adhesive
    strips on a cardboard panel to test with. Almost ready to test with
    the real LEDs.
    Turned compiler optimizations on.
2017-07-26 Button read code compiles
    Have not tested. Need to implement timer code too.
2017-07-26 Display driver now tested to work
    Tested the display driver with real LEDs. SPI settings and APA102
    protocol implementation has now been verified. Single string update
    mode still has a bug in it. Not going to fix this right now.
    [Display.cpp, MCU.cpp, main.cpp]
2017-07-31 Add gamma correction to pixels
    Added gamma correction for pixel setters. Looks better now on linear
    brightness sweep test.
    [APA102Pixel.cpp, APA102Pixel.h, main.cpp]
2017-07-31 Add timer functionality
    Got the timer peripheral working and integrated it into a basic HAL
    wrapper.
2017-08-01 Add task management code with first pattern
    Add task management code to manage timing of arbitrary tasks to be run
    in a round-robin outer-most control loop (polymorphic). Integrate
    the first tested (demo) pattern into this as a pattern to be run
    within a "pattern runner" task. Other tasks will be created for
    checking the battery and polling the user button, for example.
2017-08-04 Integrate button into Wedfestdress
    Add button polling into ButtonPollingTask task. Crude shared memory
    based inter task communication for now. Tomorrow is the wedding. Will
    replace with callback mechanism later. Callback mechanism seems the way
    to go.
    Pattern switching now works as well via button presses.
    [MCU.cpp, Wedfestdress.cpp, Wedfestdress.h, main.cpp]
2017-08-04 Tweaks to FlashyDingler pattern, pattern runner
    Updated timing of FlashyDingler and changed its twinkle algorithm to
    have a moving midpoint from which to set the bounds to on the next
    ramp up/down. Also have the pattern runner reset the patterns when
    switching to a new one.
2017-08-10 Final tweaks before the wedding!
    Added an all dark pattern so that we can always start from a known
    state. On the dress, unlike on the tester platform, some pixels start
    stuck on. It was helpful to start it, get past this uninitialized
    state by getting back to the dark pattern, then doing the ramp to
    white when we kiss at the ceremony.
    [main.cpp]
